LateralGs/rallyx_start_light/images/schematic_bb.png

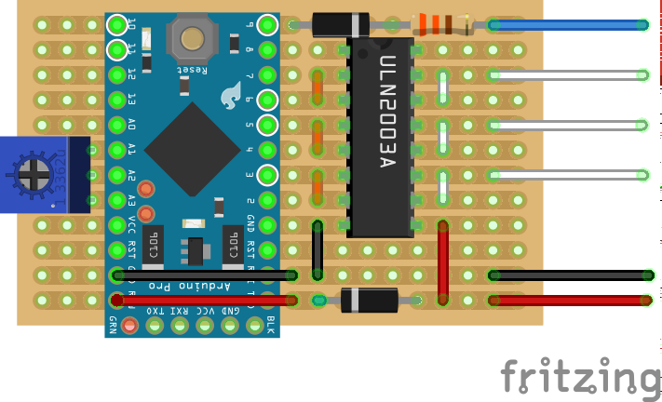
images/schematic_bb.png
